egorbrusnigin-bot/allclothes/ИНСТРУКЦИЯ.md

# Инструкция по настройке админ-панели

## Что сделано?

Я создал полноценную систему для управления твоим стритвир-маркетплейсом:

### 1. База данных (Supabase)
- **Таблица brands** - для брендов (Previous, Nike и т.д.)
- **Таблица products** - для товаров (толстовки, футболки)
- **Таблица product_images** - для нескольких фоток каждого товара
- **Таблица product_sizes** - для размеров (S, M, L, XL, XXL)
- **Storage buckets** - для хранения фотографий

### 2. Админ-панель (/admin)
- Управление брендами (добавить/редактировать/удалить)
- Управление товарами (добавить/редактировать/удалить)
- Загрузка нескольких фотографий для каждого товара
- Выбор размеров для каждого товара
- Указание цены, описания, деталей

### 3. Обновленные страницы
- **Главная** - показывает бренды из базы данных
- **Страница бренда** - показывает товары конкретного бренда
- **Страница товара** - полная информация с фотками, размерами, описанием

---

## Как настроить?

### Шаг 1: Настрой базу данных в Supabase

1. Открой твою Supabase панель: https://mvsaxxnlnzpswtyjpgkr.supabase.co

2. Слева в меню найди **SQL Editor** (значок с иконкой базы данных)

3. Открой файл `supabase-setup.sql` (он в корне проекта)

4. Скопируй весь код из этого файла

5. Вставь в SQL Editor в Supabase и нажми **RUN** (или F5)

6. Если всё прошло успешно, появится сообщение "Success"

### Шаг 2: Проверь, что создалось

В Supabase слева в меню найди **Table Editor**. Должны появиться таблицы:
- brands
- products
- product_images
- product_sizes

В **Storage** должны появиться два bucket'а:
- brand-logos
- product-images

### Шаг 3: Запусти проект

```bash
npm run dev
```

Открой http://localhost:3000

---

## Как пользоваться админкой?

### 1. Зайди в админку
Открой: http://localhost:3000/admin

### 2. Добавь бренды

**Вкладка "Бренды":**
1. Нажми **"+ Добавить бренд"**
2. Заполни форму:
   - **Название бренда**: Previous
   - **Slug (URL)**: previous (будет использоваться в URL: /brand/previous)
   - **Страна**: USA
   - **Логотип**: загрузи картинку бренда
   - **Описание**: напиши о бренде (необязательно)
3. Нажми **"Создать"**

Повтори для других брендов (Nike, Adidas, Supreme и т.д.)

### 3. Добавь товары

**Вкладка "Товары":**
1. Нажми **"+ Добавить товар"**
2. Заполни форму:
   - **Бренд**: выбери бренд из списка
   - **Название товара**: Dream Department Zip "Green"
   - **Slug (URL)**: dream-department-zip-green
   - **Цена**: 64.90
   - **Валюта**: EUR (или USD, RUB)
   - **Категория**: hoodie (или t-shirt, pants и т.д.)
   - **Описание**: опиши товар
   - **Детали**: через запятую напиши детали:
     ```
     Boxy Fit, 460 GSM Heavy Weight, 100% Cotton French Terry, Front & Sleeve Patch Embroidery
     ```
   - **Инфо о модели**: The model is 185cm tall and wears size XL
   - **Фотографии**: загрузи несколько фоток товара (можно 3-5 штук)
   - **Размеры**: выбери галочками доступные размеры (S, M, L, XL, XXL)

3. Нажми **"Создать товар"**

---

## Как это выглядит для пользователей?

### Главная страница (/)
- Показывает все бренды в виде сетки
- Клик на бренд → открывается страница бренда

### Страница бренда (/brand/previous)
- Показывает все товары этого бренда
- Клик на товар → открывается страница товара

### Страница товара (/product/dream-department-zip-green)
- Несколько фотографий (можно переключать)
- Название, цена, бренд
- Выбор размера
- Кнопка "Добавить в корзину"
- Описание и детали товара

---

## Важные моменты

### Slug (URL)
- Должен быть **уникальным**
- Только маленькие буквы, цифры и дефисы
- Плохо: `Dream Department ZIP GREEN`
- Хорошо: `dream-department-zip-green`

### Фотографии
- Загружай качественные фотки (рекомендую минимум 800x800px)
- Первая фотка будет главной
- Можно загружать по несколько штук для каждого товара

### Цены
- Указывай в формате: 64.90 (не 64,90)
- Выбирай правильную валюту (EUR/USD/RUB)

### Детали товара
- Пиши через запятую
- Например: `Boxy Fit, 460 GSM Heavy Weight, 100% Cotton`
- Каждый элемент будет показан отдельной строкой

---

## Что дальше?

После настройки ты сможешь:
- ✅ Добавлять новые бренды через админку
- ✅ Добавлять товары с фотками и размерами
- ✅ Редактировать и удалять всё прямо на сайте
- ✅ Пользователи увидят всё на главной странице и страницах брендов

---

## Если что-то не работает

1. **Ошибка при создании бренда/товара:**
   - Проверь, что выполнил SQL-скрипт в Supabase
   - Проверь, что создались все таблицы и bucket'ы

2. **Фотографии не загружаются:**
   - Проверь в Supabase → Storage → Policies
   - Убедись, что политики созданы (должны быть из SQL-скрипта)

3. **Ничего не показывается на главной:**
   - Сначала добавь хотя бы один бренд через админку
   - Перезагрузи страницу (Ctrl+R)

4. **Товары не показываются на странице бренда:**
   - Убедись, что при создании товара ты выбрал правильный бренд
   - Проверь, что у товара есть хотя бы одна фотография

---

## Контакты

Если нужна помощь или хочешь добавить новые фичи - пиши!

**Успехов с маркетплейсом! 🚀**
