egorbrusnigin-bot/allclothes/public/ALLCLOTHES.png

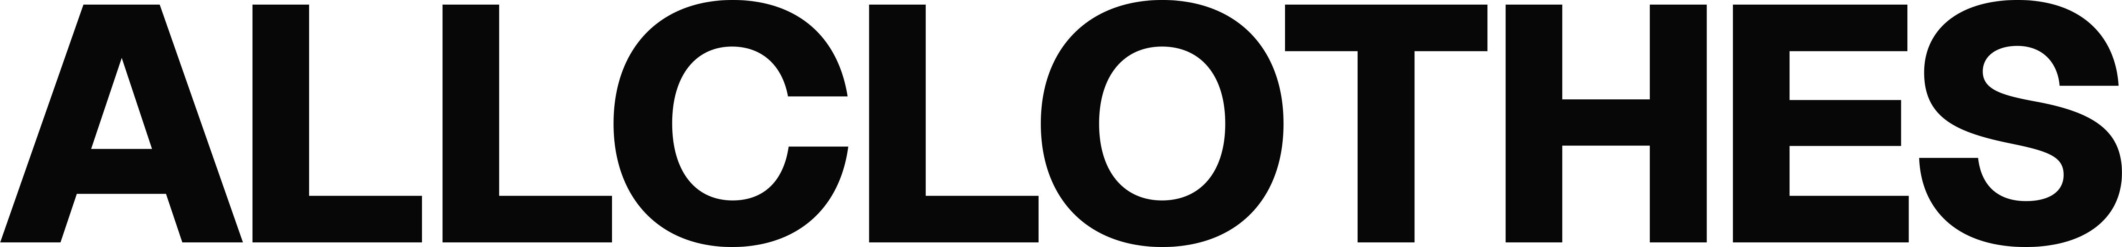
public/ALLCLOTHES.png
