egorbrusnigin-bot/allclothes/libre-diabetica/stl/circlip/libre_2_base_circlip.stl

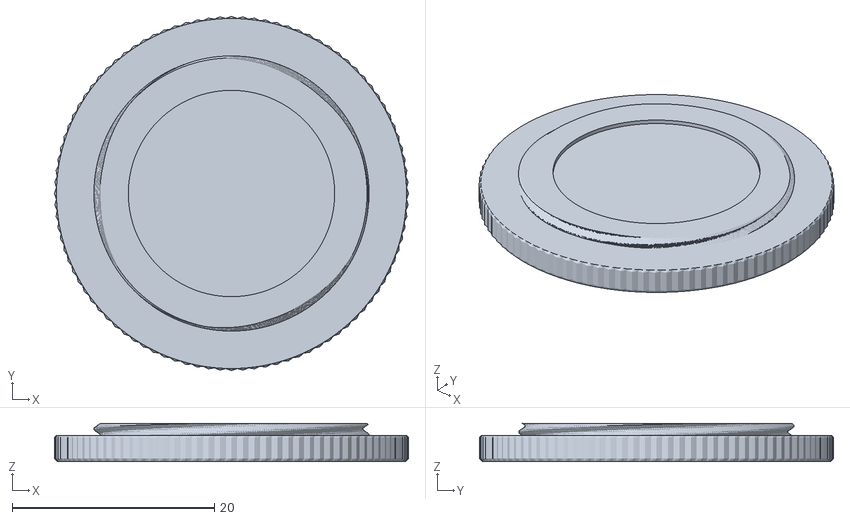
[picture p4: CAD file, 2026-10-03]
libre-diabetica/stl/circlip/libre_2_base_circlip.stl
35.0 x 35.0 x 3.80
