egorbrusnigin-bot/allclothes/libre-diabetica/stl/libre_1_cap.stl

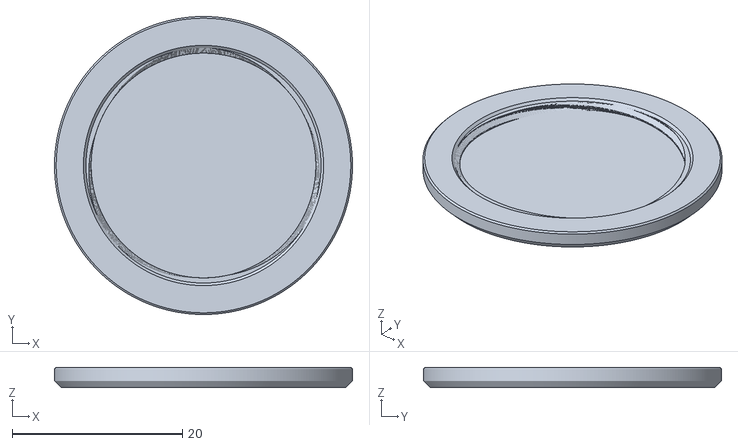
[picture p5: CAD file, 2026-09-30]
libre-diabetica/stl/libre_1_cap.stl
35.0 x 35.0 x 2.40
