egorbrusnigin-bot/allclothes/libre-diabetica/stl/circlip/libre_3_ring_circlip.stl

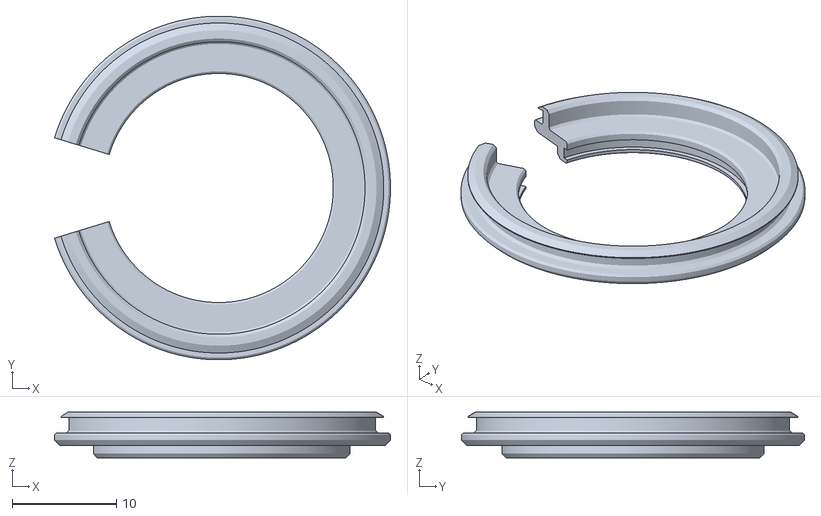
[picture p6: CAD file, 2026-10-03]
libre-diabetica/stl/circlip/libre_3_ring_circlip.stl
32.3 x 33.0 x 4.40
