egorbrusnigin-bot/allclothes/libre-diabetica/stl/click/libre_4_lock_click.stl

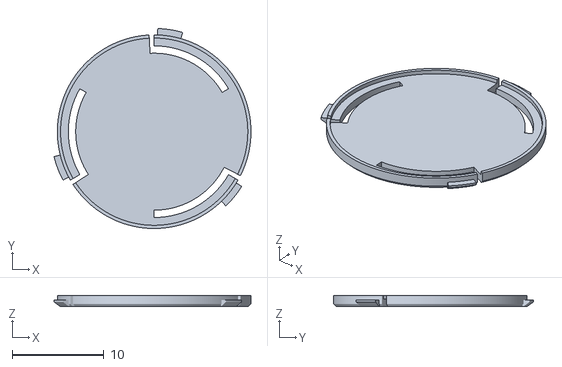
[picture p7: CAD file, 2026-09-30]
libre-diabetica/stl/click/libre_4_lock_click.stl
21.5 x 21.8 x 1.20
