egorbrusnigin-bot/allclothes/libre-diabetica/stl/libre_4_lock.stl

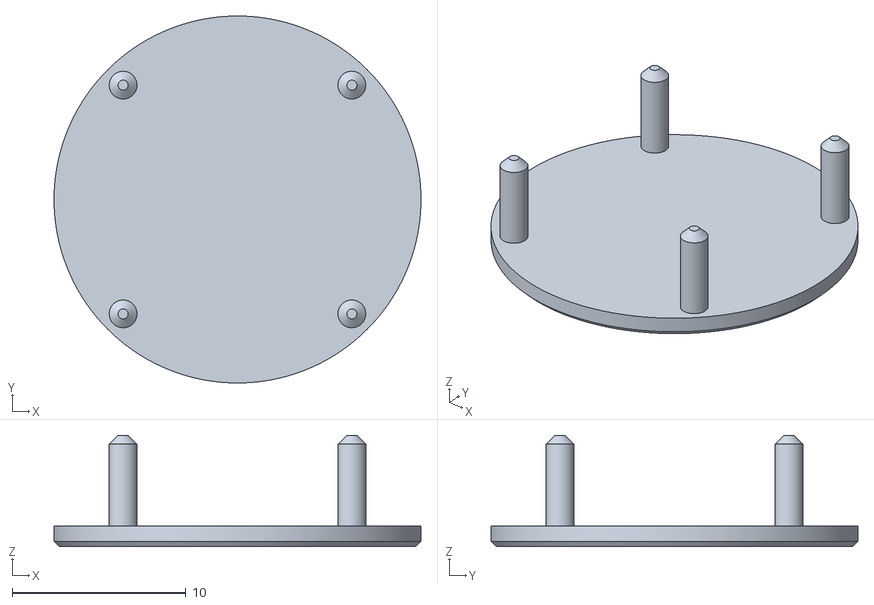
[picture p8: CAD file, 2026-09-30]
libre-diabetica/stl/libre_4_lock.stl
21.1 x 21.1 x 6.40
