egorbrusnigin-bot/allclothes/libre-diabetica/stl/libre_3_ring.stl

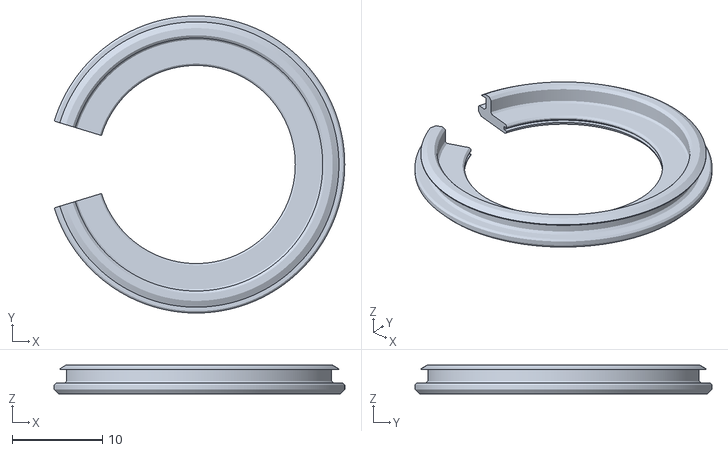
[picture p9: CAD file, 2026-09-30]
libre-diabetica/stl/libre_3_ring.stl
32.3 x 33.0 x 3.20
