egorbrusnigin-bot/allclothes/(list of files, cad)

Other CAD files:
libre-diabetica/stl/click/libre_2_base_click.stl
libre-diabetica/stl/libre_2_base.stl
