egorbrusnigin-bot/allclothes/(commit log)

2026-02-05 Update site: new logo, auth flow, currency selector
    - Add ALLCLOTHES logo image
    - Fix Google OAuth callback (direct login without magic link step)
    - Add auth callback page
    - Add become-seller page
    - Add currency selector
    - Add LoadingLogo component
    - Various UI updates
2026-02-09 Globe map with smooth marker fade, Stripe integration, catalog improvements
    - Map: globe projection, dark dataviz style, brand markers with logo avatars
    - Map: smooth opacity fade for markers near globe edges
    - Map: improved popup design with brand logo and layout
    - Stripe Connect integration for sellers
    - Seller orders page
    - Analytics dashboard for moderation
    - Catalog page improvements
    - Checkout flow updates
    - Gallery page
2026-02-10 Fix mobile menu design and add map login gate
    - Fix Safari currency selector: remove round appearance with -webkit-appearance: none
    - Redesign SIGN UP/LOG IN buttons as equal-width side-by-side buttons
    - Map page: show login prompt for non-registered users on mobile
    - ACCOUNT/FAVORITES buttons also styled consistently
2026-02-14 Optimize animations for weak devices
    - Throttle LogoParticles to 30fps, pause when off-screen
    - Remove universal * transition, scope to buttons/links only
    - Remove haversine calculations and backdrop-filter from map markers
    - Add prefers-reduced-motion support
2026-09-29 Libre diabetica: sensor on a t-shirt, exploded view, printable STL, split clip ring
    - Viewer now builds a t-shirt in the browser and puts the sensor on the sleeve;
    the explode slider separates cap, tag, body and ring, unwraps the fabric and
    fades the shirt so the ring inside the sleeve shows
    - STL download buttons (mm, Z up, parts on the plate) plus the same files in stl/
    - Ring is now a split C-ring that hooks 0.55 mm behind the body lip plastic on
    plastic for 0.3-0.6 mm fabric; the old solid ring only held by fabric thickness
    - build_parts.py regenerates body and ring, checks the fit and refreshes page and STL
    Claude-Session: h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
    [libre_1_cap_white.stl, libre_2_body_clear.stl, libre_3_ring_inside.stl]
2026-09-29 Libre diabetica: glue key between cap and body
    A rib under the cap sits in a groove on top of the body with a 0.1 mm glue gap.
    It centres the cap, keeps a continuous ring of glue and takes sideways knocks in
    shear instead of peeling the edge. README explains how to bond resin (UV resin,
    cured through the clear body) and PETG (two-part epoxy).
    Claude-Session: https://claude.ai/code/session_01U8heFqDitgvUthNS6yb1hD
    [libre_1_cap_white.stl, libre_2_body_clear.stl]
2026-09-29 Libre diabetica: FDM version of the cap and FDM print guide
    The resin cap has a 0.24 mm dome and a 0.15 mm engraving, neither prints on FDM
    without supports. The FDM cap has a flat face so it prints face down on the bed,
    a 45° edge, no engraving and FDM clearances (0.15 mm at the glue rib, 0.2 mm at
    the skirt). Page gets a download button; README covers plastics, slicer settings
    and smoothing.
    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
    [libre_1_cap_white_FDM.stl]
2026-09-30 Libre diabetica: picture of the FDM plate orientation
    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
2026-09-30 Libre diabetica: screw-on swappable cap, lock disc with NFC, rivet variant
    - Cap is smooth (no hub steps) and screws onto the base with a 3-start thread,
    a third of a turn to close; teeth catch all the way round, 2.5° lead holds by
    friction. Fronts can be swapped.
    - Ring hooks 0.8 mm behind the lip (was 0.55), gentler lead-in, wider cut.
    - Lock disc clicks into the middle of the ring so it can no longer be squeezed
    out; it carries a Ø20 NFC sticker under the fabric.
    - Rivet variant: lock with four pins through fabric and base, melted over on
    top of the base; Ø15 NFC.
    - Page, section drawings, bed layout and README updated; parts are FDM/PETG.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
    [libre_1_cap.stl, libre_1_cap_white.stl, libre_1_cap_white_FDM.stl, libre_2_base.stl, libre_2_base_RIVET.stl, libre_2_body_clear.stl, libre_3_ring.stl, libre_3_ring_inside.stl]
2026-09-30 Libre diabetica: two permanent variants on the page, wash-proofing
    - Page switches between variant 1 (rivet lock: pins melted over on top of the
    base) and variant 2 (click lock + E6000, no holes in the fabric).
    - Silicone O-ring 30x1 under the cap keeps the thread tight through washes and
    seals it; NFC sticker sealed inside the rivet lock (print paused at 0.8 mm).
    - Thicker rivet pins (1.6 mm) with entry funnels under the base holes.
    - README: files, bought parts, what washing does and the care instructions.
    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
    [libre_1_cap.stl, libre_2_base.stl, libre_2_base_RIVET.stl, libre_2_base_click.stl, libre_4_lock.stl, libre_4_lock_RIVET.stl, libre_4_lock_click.stl]
2026-09-30 Libre diabetica: 'diabetica' pressed into the cap face
    Debossed 0.4 mm, 22 x 3.3 mm, bold sans so a 0.4 mm nozzle draws it; the face
    prints on the bed, so the letters come out crisp.
    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
    [libre_1_cap.stl]
2026-09-30 Libre diabetica: drop the O-ring, cap is unscrewed before washing
    No bought parts under the cap any more. Page and README say to take the cap off
    before washing; the cap description mentions the pressed-in name.
    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
    [libre_1_cap.stl]
2026-09-30 Libre diabetica: 'diabetica' back on the side of the cap, face smooth
    Same place as the original model: centred on the side wall, 1.2 mm tall,
    0.3 mm deep; the cap face is plain again.
    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
    [libre_1_cap.stl]
2026-10-03 Libre diabetica: variant 3, steel circlip in the middle of the ring
    A standard internal circlip for a 22 mm bore (DIN 472 22x1.0) clicks into a groove
    in a deeper hub of the plastic ring and keeps it from shrinking; its cut sits
    opposite the ring's cut. No holes, no glue, no soldering; comes out only with
    circlip pliers. The Ø20 NFC sticker moves into the top of the base, away from
    the steel. Shown on the page as a third mounting option.
    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
    [libre_2_base_circlip.stl, libre_3_ring_circlip.stl]
